Staskaer/controller/docs/mp4/1.png

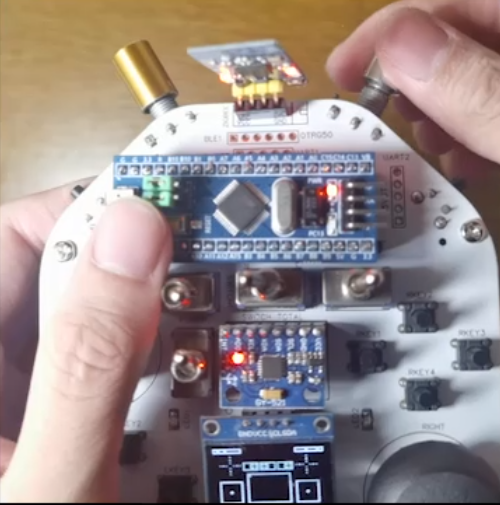
docs/mp4/1.png
