Staskaer/controller/docs/mp4/2.png

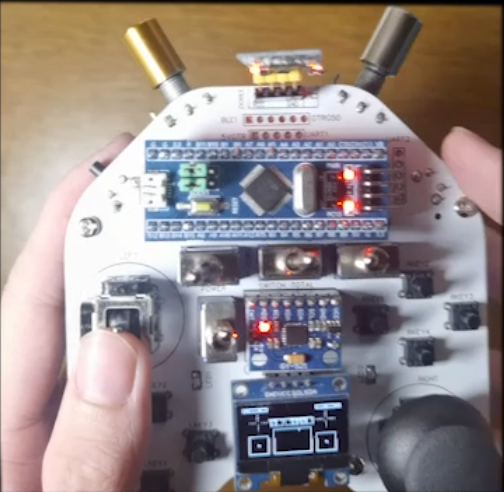
docs/mp4/2.png
