Staskaer/controller/docs/pcd_order.md

~~简写了，期待有人pr~~

1. 首先登录[嘉立创eda平台](https://lceda.cn/editor#)，并新建工程
2. 将`PCB`文件夹下的两个json格式文件拖到页面中，并保存在您的工程里
3. 按修修改
4. 在PCB页面点击`制造--一键PCB/SMT下单`
5. 领券下单即可，建议选白色好看
