Staskaer/controller/keil_project/controller.ioc

Mcu.UserName=STM32F103C8Tx
PA0-WKUP.GPIO_Label=R_UP_R
PA0-WKUP.Signal=ADCx_IN0
PA1.GPIO_Label=R_UP_L
PA1.Signal=ADCx_IN1
PA10.GPIO_Label=LED1
PA10.Signal=GPIO_Output
PA11.GPIO_Label=SWITCH_TOTAL
PA11.Signal=GPIO_Input
PA12.GPIO_Label=KEY_UP_L
PA12.Signal=GPIO_Input
PA13.Signal=SYS_JTMS-SWDIO
PA14.Signal=SYS_JTCK-SWCLK
PA15.GPIO_Label=KEY_L_4
PA15.Signal=GPIO_Input
PA2.Signal=USART2_TX
PA3.Signal=USART2_RX
PA4.GPIO_Label=R_L_Y
PA4.Signal=ADCx_IN4
PA5.GPIO_Label=R_L_X
PA5.Signal=ADCx_IN5
PA6.GPIO_Label=R_R_Y
PA6.Signal=ADCx_IN6
PA7.GPIO_Label=R_R_X
PA7.Signal=ADCx_IN7
PA8.GPIO_Label=SWITCH1
PA8.Signal=GPIO_Input
PA9.GPIO_Label=LED2
PA9.Signal=GPIO_Output
PB0.GPIO_Label=KEY_L_1
PB0.Signal=GPIO_Input
PB1.GPIO_Label=KEY_L_2
PB1.Signal=GPIO_Input
PB10.Signal=I2C2_SCL
PB11.Signal=I2C2_SDA
PB12.GPIO_Label=KEY_R_1
PB12.Signal=GPIO_Input
PB13.GPIO_Label=KEY_R_2
PB13.Signal=GPIO_Input
PB14.GPIO_Label=KEY_R_3
PB14.Signal=GPIO_Input
PB15.GPIO_Label=SWITCH2
PB15.Signal=GPIO_Input
PB3.GPIO_Label=KEY_R_4
PB3.Signal=GPIO_Input
PB4.GPIO_Label=KEY_UP_R
PB4.Signal=GPIO_Input
PB5.GPIO_Label=KEY_L_3
PB5.Signal=GPIO_Input
PB6.Signal=USART1_TX
PB7.Signal=USART1_RX
PB8.Signal=I2C1_SCL
PB9.Signal=I2C1_SDA
PC13-TAMPER-RTC.GPIO_Label=LED
PC13-TAMPER-RTC.Signal=GPIO_Output
PC14-OSC32_IN.Signal=RCC_OSC32_IN
PC15-OSC32_OUT.Signal=RCC_OSC32_OUT
PD0-OSC_IN.Signal=RCC_OSC_IN
PD1-OSC_OUT.Signal=RCC_OSC_OUT
