Staskaer/controller/keil_project/Core/Inc/main.h

#define LED_Pin GPIO_PIN_13
#define LED_GPIO_Port GPIOC
#define R_UP_R_Pin GPIO_PIN_0
#define R_UP_R_GPIO_Port GPIOA
#define R_UP_L_Pin GPIO_PIN_1
#define R_UP_L_GPIO_Port GPIOA
#define R_L_Y_Pin GPIO_PIN_4
#define R_L_Y_GPIO_Port GPIOA
#define R_L_X_Pin GPIO_PIN_5
#define R_L_X_GPIO_Port GPIOA
#define R_R_Y_Pin GPIO_PIN_6
#define R_R_Y_GPIO_Port GPIOA
#define R_R_X_Pin GPIO_PIN_7
#define R_R_X_GPIO_Port GPIOA
#define KEY_L_1_Pin GPIO_PIN_0
#define KEY_L_1_GPIO_Port GPIOB
#define KEY_L_2_Pin GPIO_PIN_1
#define KEY_L_2_GPIO_Port GPIOB
#define KEY_R_1_Pin GPIO_PIN_12
#define KEY_R_1_GPIO_Port GPIOB
#define KEY_R_2_Pin GPIO_PIN_13
#define KEY_R_2_GPIO_Port GPIOB
#define KEY_R_3_Pin GPIO_PIN_14
#define KEY_R_3_GPIO_Port GPIOB
#define SWITCH2_Pin GPIO_PIN_15
#define SWITCH2_GPIO_Port GPIOB
#define SWITCH1_Pin GPIO_PIN_8
#define SWITCH1_GPIO_Port GPIOA
#define LED2_Pin GPIO_PIN_9
#define LED2_GPIO_Port GPIOA
#define LED1_Pin GPIO_PIN_10
#define LED1_GPIO_Port GPIOA
#define SWITCH_TOTAL_Pin GPIO_PIN_11
#define SWITCH_TOTAL_GPIO_Port GPIOA
#define KEY_UP_L_Pin GPIO_PIN_12
#define KEY_UP_L_GPIO_Port GPIOA
#define KEY_L_4_Pin GPIO_PIN_15
#define KEY_L_4_GPIO_Port GPIOA
#define KEY_R_4_Pin GPIO_PIN_3
#define KEY_R_4_GPIO_Port GPIOB
#define KEY_UP_R_Pin GPIO_PIN_4
#define KEY_UP_R_GPIO_Port GPIOB
#define KEY_L_3_Pin GPIO_PIN_5
#define KEY_L_3_GPIO_Port GPIOB
