Staskaer/controller/(commit log)

2023-10-07 pcb files
2023-10-09 add bom.md
2023-10-09 add pcb_order
2023-11-08 information about the switch
